Rattiputz/plateforme-robotique-mobile/Architecture/Architecture.jpg

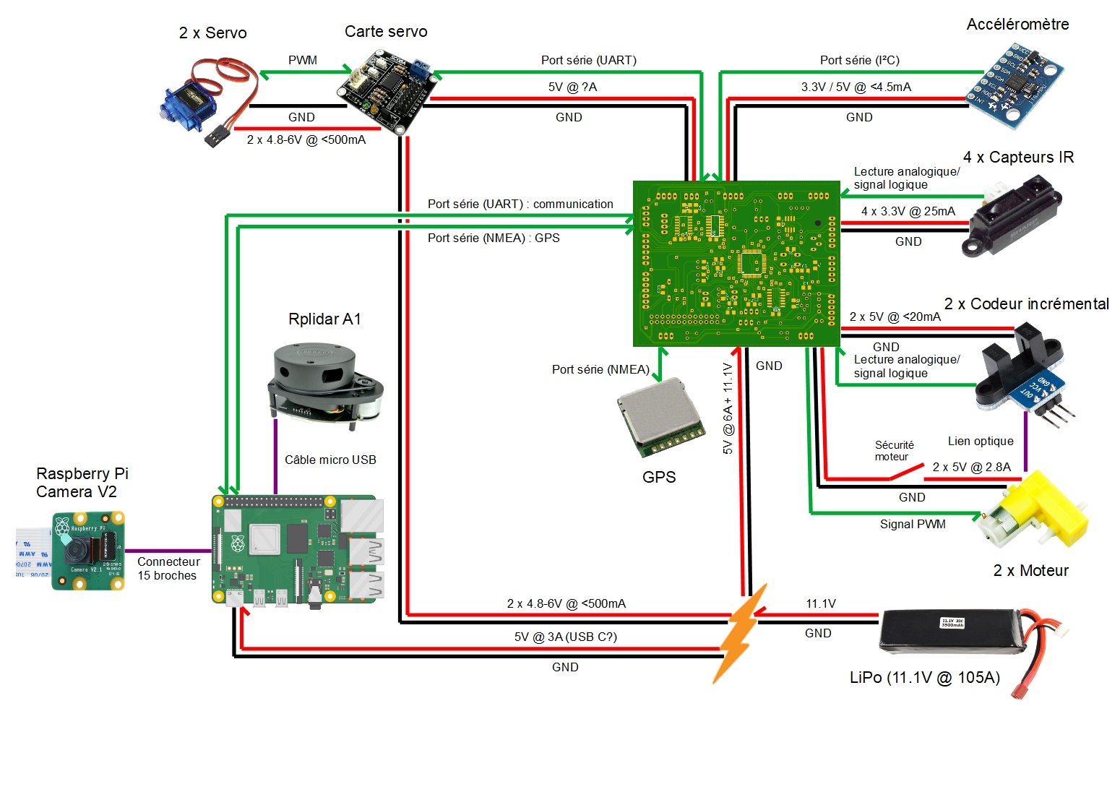
Architecture/Architecture.jpg
