Rattiputz/plateforme-robotique-mobile/prm_ws/src/prm_navigation/README.md

# prm_navigation

Le pkg prm_description contient :
- prm_teleop.launch qui permet le contrôle du robot par clavier
- amcl_demo.launch charge la carte de l'environnement et prépare le lancement de rviz (prm_descritption prm_rviz_amcl.launch) pour l'amcl
- gmapping_demo.launch prépare le lancement de rviz pour générer une carte (prm_decription prm_rviz_gmapping.launch)
