Rattiputz/plateforme-robotique-mobile/prm_ws/src/prm_description/README.md

# prm_description

Le pkg prm_description contient :
- prm_rviz.launch qui lance rviz pour visualiser les capteurs à partir du modèle sur ROS
- prm_rviz_amcl.launch qui lance rviz avec le Lidar activé
- prm_rviz_gmapping.launch qui lance rviz aussi... A COMPLETER :(
