Rattiputz/plateforme-robotique-mobile/Architecture/Architecture.odt

Architecture PRM

# Processeurs

- Raspberry Pi 4 B
- Microcontrôleur (PIC18F46K22-IPT)

# Capteurs

- RPLidar A1
- GPS
- Raspberry Pi Carte d’appareil photo V2
- 4 x Capteur distance infrarouge
- Accéléromètre 3 axes
- 2 x Codeur incrémental

# Alimentation

- Raspberry Pi 4 B (5V @ 3A) : Raspberry + Lidar + Camera
- Microcontrôleur (3.3V @ ??A)
- Moteurs (6V @ 2.8A) + Driver moteur
- 2 x Servo (4.8-6V @ 500mA) + Driver servos

Alimentation | V | A | Convertisseur | Fusible : 1 fusible en entrée (@11.1V)
Servomoteurs | 5V | 1.5A | OKI-78SR-5/1.5-W36-C | 0.68A
Moteurs | 5V | 6A | TOS06_12SIL | 2.7A
Raspberry Pi 4 + cartes 5V | 5V | 3.5A | TOS06_12SIL | 2.7A
µC + capteurs + GPS + autre | 3.3V | 500mA | R-78E3.3-0.5 | 0.23A

Fusible @ 11.1V : 6.3A

Liens :

# OKI-78SR-5/1.5-W36-C : https://fr.farnell.com/murata-power-solutions/oki-78sr-5-1-5-w36-c/convertisseur-dc-dc-7-5w-simple/dp/2102101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

TOS06_12SIL : https://fr.farnell.com/tracopower/tos-06-12sil/convertisseur-dc-dc-pol-6a-5v/dp/1007593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

# R-78E3.3-0.5 : https://fr.farnell.com/recom-power/r-78e3-3-0-5/conv-dc-dc-3-3v-500ma-out-thru/dp/2218602

LP2950-33LPE3 : https://fr.farnell.com/texas-instruments/lp2950-33lpe3/regulateur-micrpwr-3-3v-sd-to92/dp/2436388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

SPI : https://learn.sparkfun.com/tutorials/serial-peripheral-interface-spi/all

http://ww1.microchip.com/downloads/en/devicedoc/spi.pdf
