Rattiputz/plateforme-robotique-mobile/prm_ws/src/prm_control/README.md

# prm_control

Le pkg prm_control contient prm_control.launch qui initialise les controlleurs (tourelle caméra, roues...).
