Rattiputz/plateforme-robotique-mobile/prm_ws/src/prm_gazebo/README.md

# prm_gazebo

Le pkg prm_description contient prm_world.launch qui démarre la simulation sur gazebo et lace le robot.
