Rattiputz/plateforme-robotique-mobile/documentation/Electronique/Carte_uc_pcb.png

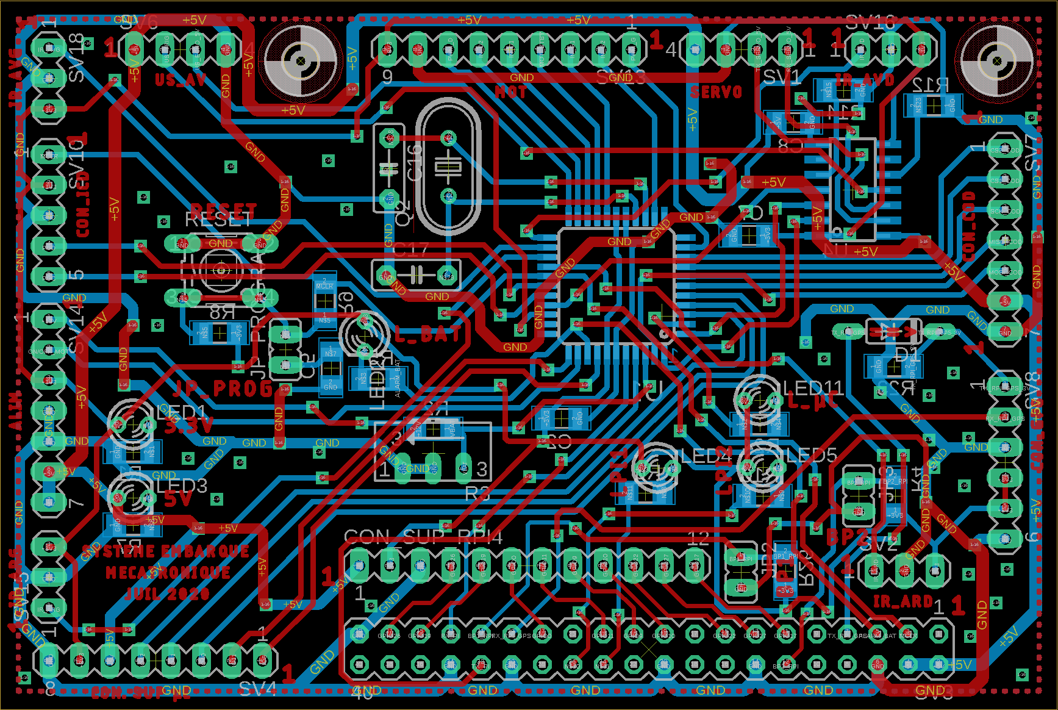
documentation/Electronique/Carte_uc_pcb.png
