Rattiputz/plateforme-robotique-mobile/documentation/Electronique/Carte_uc_schema.png

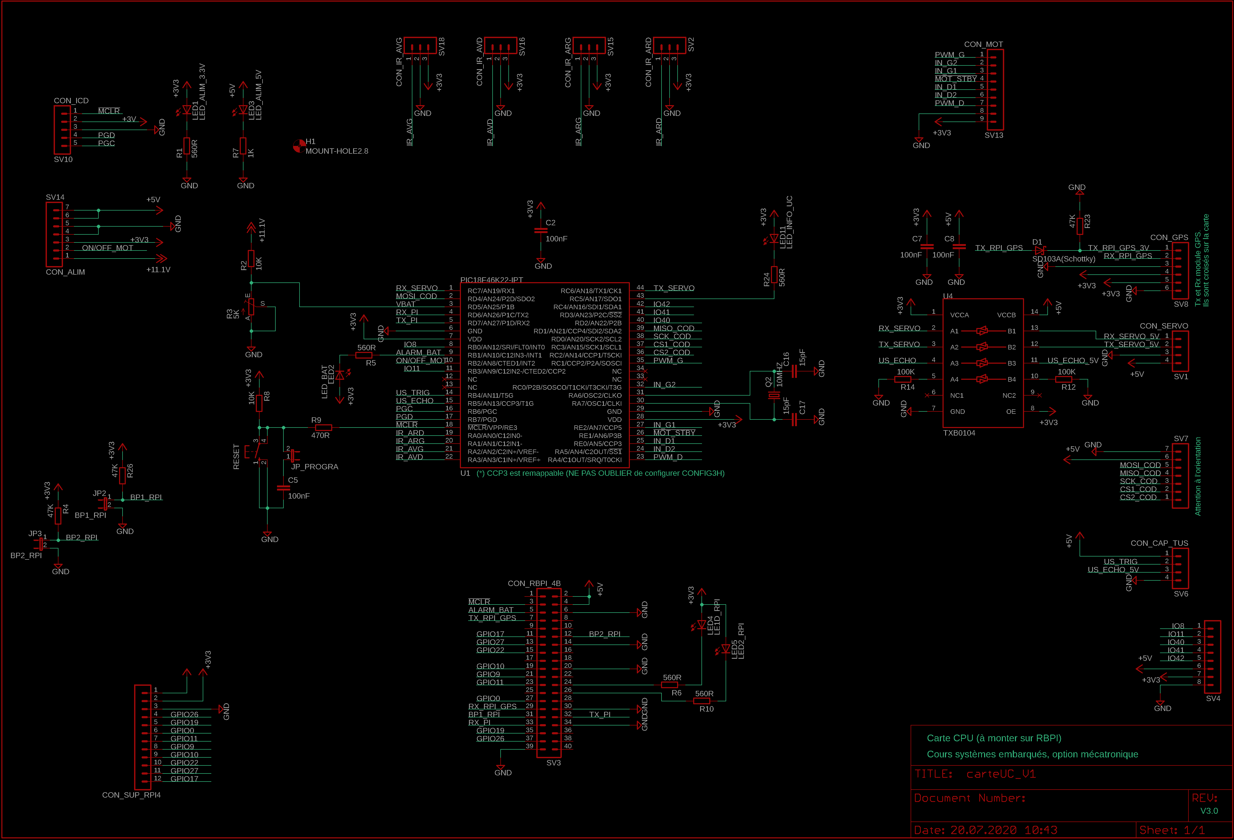
documentation/Electronique/Carte_uc_schema.png
