Rattiputz/plateforme-robotique-mobile/CAO/PRM_components_urdf_description/meshes/camera_1.stl

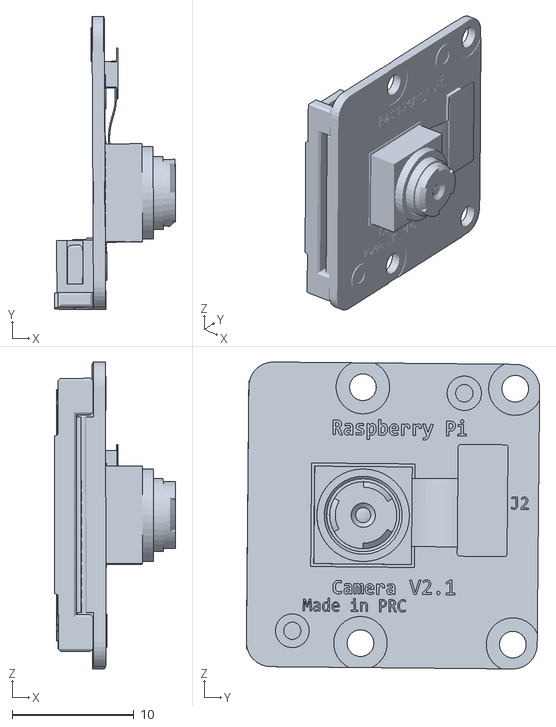
[picture p10: CAD file, 2020-05-07]
CAO/PRM_components_urdf_description/meshes/camera_1.stl
9.94 x 24.1 x 25.2
