Rattiputz/plateforme-robotique-mobile/prm_ws/src/prm_description/meshes/right_wheel_3.stl

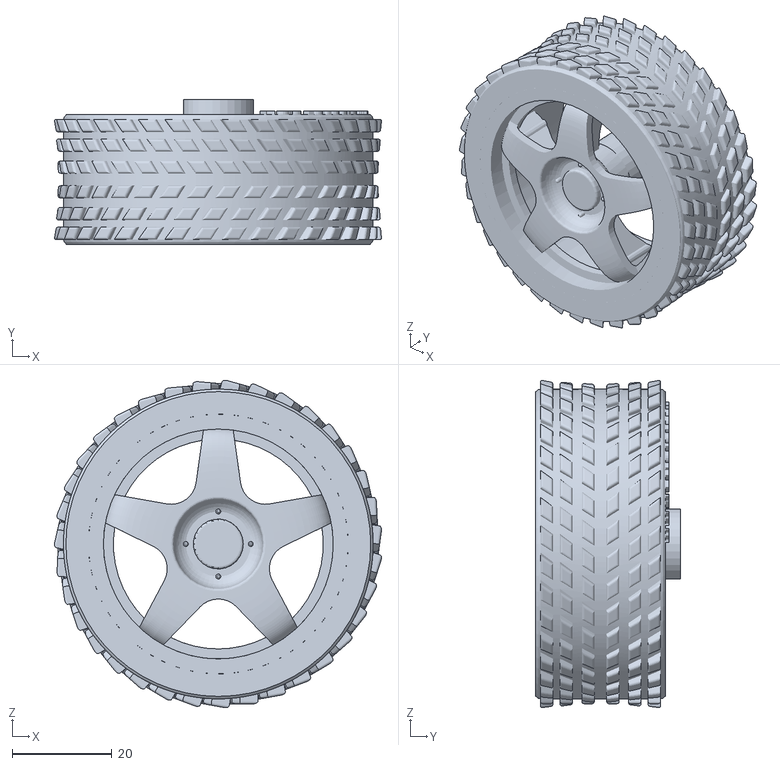
[picture p11: CAD file, 2020-05-07]
prm_ws/src/prm_description/meshes/right_wheel_3.stl
65.4 x 29.0 x 65.5
