Rattiputz/plateforme-robotique-mobile/CAO/PRM_components_urdf_description/meshes/lien_plaque_sup_1.stl

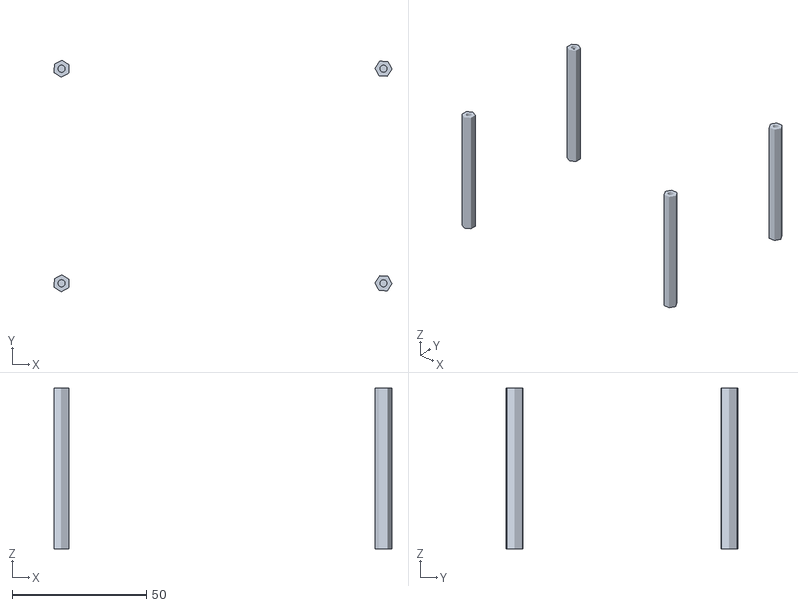
[picture p12: CAD file, 2020-05-07]
CAO/PRM_components_urdf_description/meshes/lien_plaque_sup_1.stl
126.0 x 86.3 x 60.0
