Rattiputz/plateforme-robotique-mobile/prm_ws/src/prm_description/meshes/base_link.stl

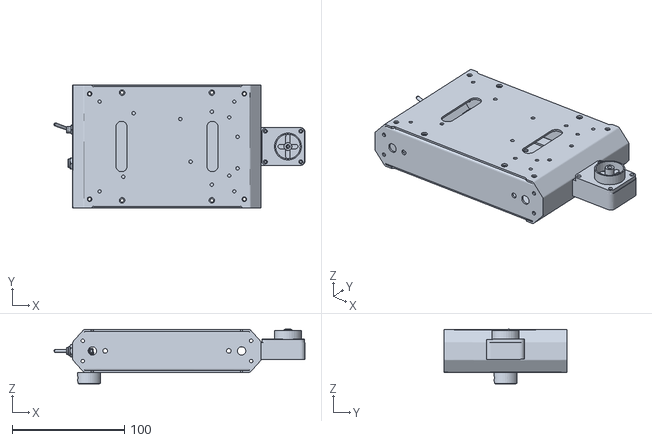
[picture p13: CAD file, 2020-05-07]
prm_ws/src/prm_description/meshes/base_link.stl
223.7 x 110.0 x 48.6
