Rattiputz/plateforme-robotique-mobile/CAO/PRM_components_urdf_description/meshes/plaque_sup_1.stl

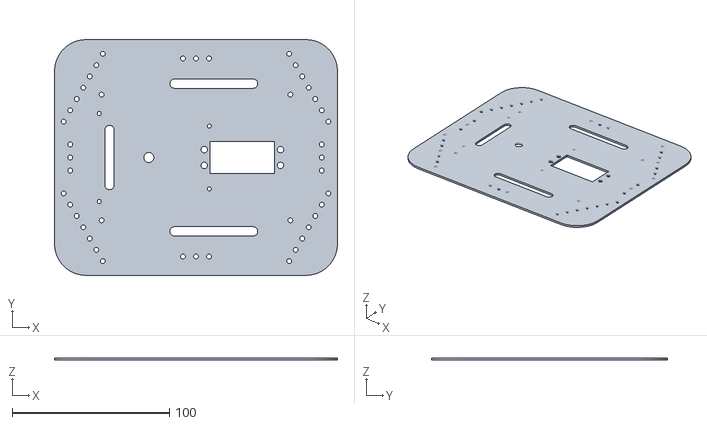
[picture p14: CAD file, 2020-05-07]
CAO/PRM_components_urdf_description/meshes/plaque_sup_1.stl
180.0 x 150.0 x 1.50
