Rattiputz/plateforme-robotique-mobile/prm_ws/src/prm_description/meshes/left_wheel_1.stl

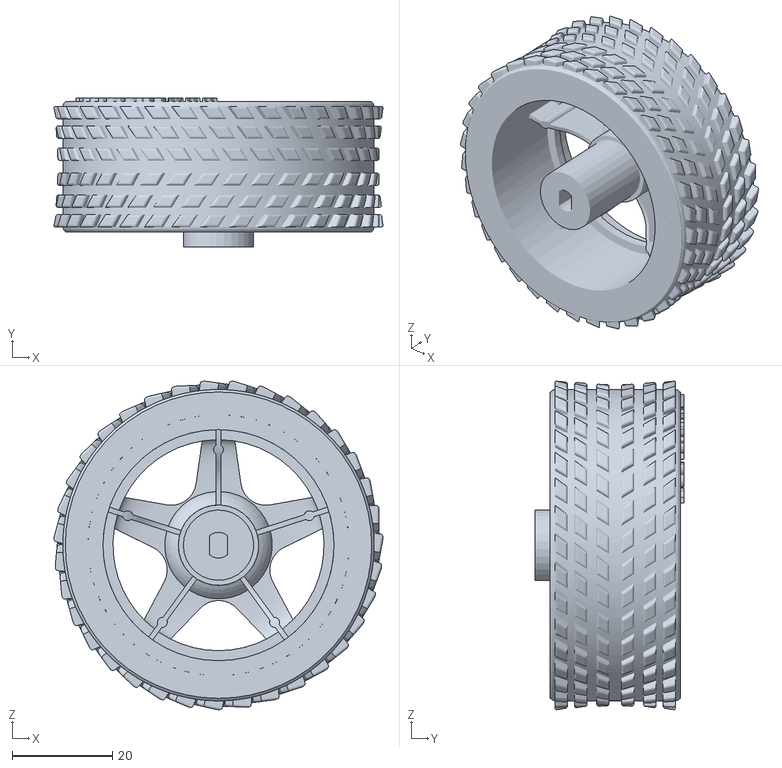
[picture p15: CAD file, 2020-05-07]
prm_ws/src/prm_description/meshes/left_wheel_1.stl
65.5 x 29.7 x 65.4
