Rattiputz/plateforme-robotique-mobile/CAO/PRM_components_urdf_description/meshes/pan_1.stl

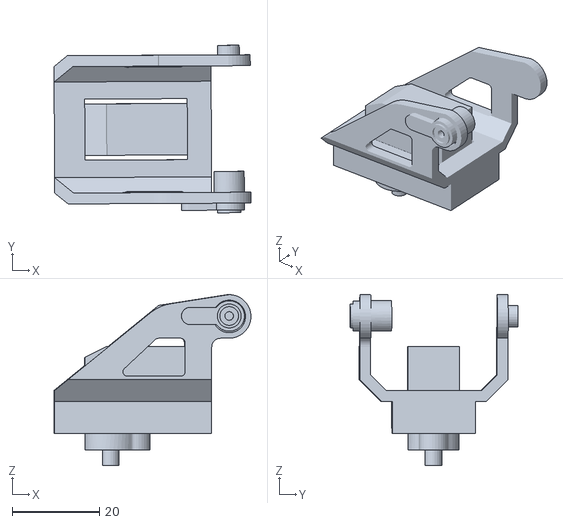
[picture p16: CAD file, 2020-05-07]
CAO/PRM_components_urdf_description/meshes/pan_1.stl
45.2 x 38.4 x 39.2
