Rattiputz/plateforme-robotique-mobile/CAO/PRM_components_urdf_description/meshes/bille_porteuse_1.stl

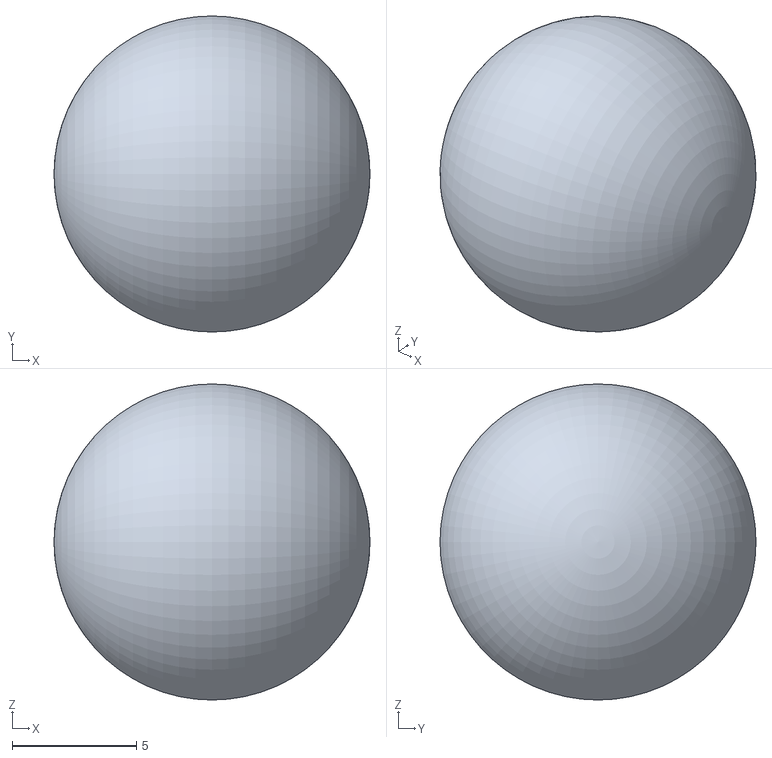
[picture p17: CAD file, 2020-05-07]
CAO/PRM_components_urdf_description/meshes/bille_porteuse_1.stl
12.7 x 12.7 x 12.7
