Rattiputz/plateforme-robotique-mobile/prm_ws/src/prm_description/meshes/laser_1.stl

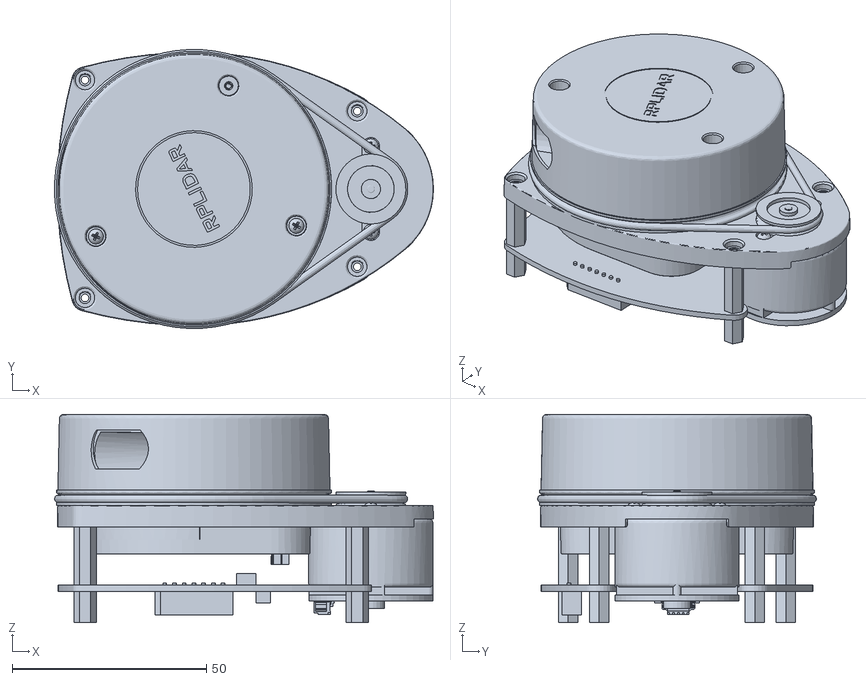
[picture p18: CAD file, 2020-05-07]
prm_ws/src/prm_description/meshes/laser_1.stl
97.4 x 71.7 x 53.5
