Rattiputz/plateforme-robotique-mobile/prm_ws/src/prm_description/meshes/tilt_1.stl

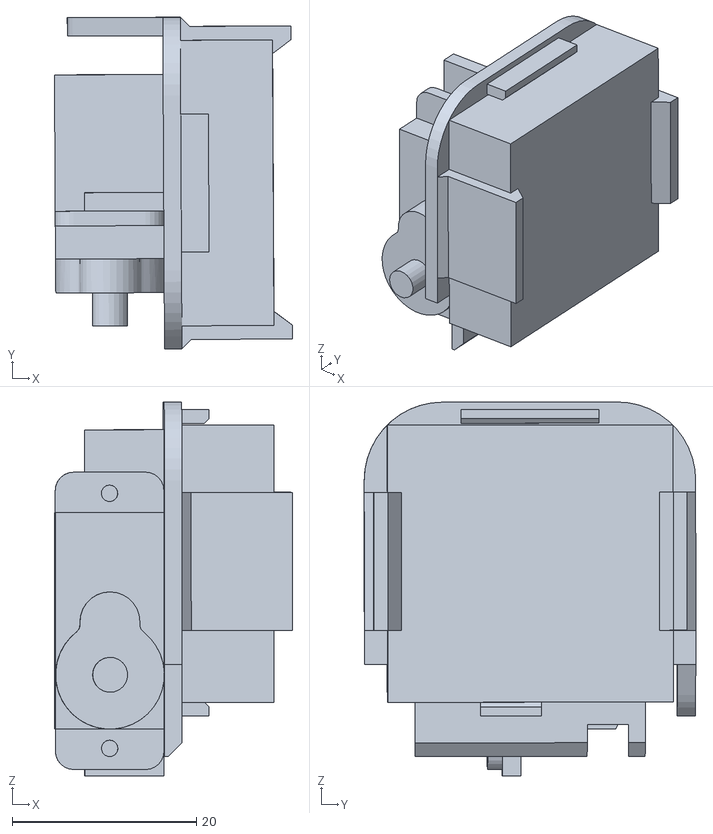
[picture p19: CAD file, 2020-05-07]
prm_ws/src/prm_description/meshes/tilt_1.stl
25.9 x 36.0 x 40.6
