Rattiputz/plateforme-robotique-mobile/documentation/procedes_installation.txt

Préliminaires --------------------------------------------

Drivers Nvidia:
Avant tout, tester si le pc s'éteint correctement. Si non, installer les drivers nvidia avec:

sudo apt-get install nvidia-384
ou
sudo apt-get install nvidia-430

Tutorial GitHub:
https://product.hubspot.com/blog/git-and-github-tutorial-for-beginners

Installation de ROS sur ordinateur --------------------------------------------

ROS:
http://wiki.ros.org/kinetic/Installation/Ubuntu (installer ros-kinetic-ros-base)

1. Ici on n'installe que ROS base (sudo apt-get install ros-kinetic-ros-base). Par la suite, nous installerons gazebo9 (alors que la version par défaut est gazebo7). Nous installerons les autres packages nécessaires manuellement.

2. Vérifier que ROS est bien installé avec:

roscore

(passer à la suite après l'actualisation de rosdep).

Gazebo9 (seulement sur ordinateur):
https://medium.com/@abhiksingla10/setting-up-ros-kinetic-and-gazebo-8-or-9-70f2231af21a
http://gazebosim.org/tutorials?tut=install_ubuntu&cat=install

1. Suivre les instructions manuelles du deuxième lien pour récupérer les repos des versions de gazebo adaptées à ROS kinetic (ne pas installer gazebo-11).
2. Reprendre le premier lien à l'installation de gazebo9. S'assurer que les packages sont bien présents auparavent.

En plus des packages cités, installer:

1. sudo apt-get install ros-kinetic-joint-state-publisher ros-kinetic-joint-state-publisher-gui ros-kinetic-robot-state-publisher (bon lancement de rviz)
2. sudo apt-get install ros-kinetic-gmapping (gmapping)
3. sudo apt-get install ros-kinetic-turtlebot (diriger le robot au clavier)
4. sudo apt-get install ros-kinetic-map-server ros-kinetic-amcl ros-kinetic-move-base (permettre la navigation autonome)
5. sudo apt-get install ros-kinetic-tf-conversions (hector slam)

Installation de Ubuntu Mate 16.04 sur Raspberry Pi 4 --------------------------------------------

Ubuntu 16.04 Mate sur Raspberry Pi 4:

https://ubuntu-mate.community/t/is-there-a-ubuntu-mate-for-raspberry-pi-4/19943/4

0. S'il y a des problèmes pour connecter la carte SD à l'ordinateur, la commande suivante devrait résoudre le problème (il faut malheureusement redémarrer le PC à chaque fois):

sudo apt-get install --reinstall udisks2
sudo reboot

1. Ce procédé est plus simple avec 2 cartes SD, mais une suffit (effectuer d'abord l'étape 2.). Sur une première carte SD, flasher Ubuntu 16.04 Mate (armhf) de manière native (Ubuntu) ou avec un outil dédié (Windows, type BalenaEtcher). Pour télécharger Ubuntu:

wget https://ubuntu-mate.org/raspberry-pi/ubuntu-mate-16.04.2-desktop-armhf-raspberry-pi.img.xz

2. Sur une deuxième carte SD, flasher Raspian Buster:

https://www.raspberrypi.org/downloads/raspbian/

3. Enregistrer /boot et /rootfs/lib/modules de l'image Raspian. Supprimer le boot de la carte avec Ubuntu et remplacer par le /boot enregistré. Remplacer /rootfs/lib/modules de Ubuntu par le dossier /modules enregistré.

4. Changer cmdline.txt (dans /boot) en:

dwc_otg.lpm_enable=0 console=serial0,115200 console=tty1 root=/dev/mmcblk0p2 rootfstype=ext4 elevator=deadline fsck.repair=yes rootwait

Normalement il faudrait changer le PARTUUID (ou le UUID) dans cette ligne de commande. Puisqu'il est apparement difficile de le trouver sur le système modifié (il ne démarre pas avant d'avoir renseigné le UUID), cette solution est plus simple: on renseigne au /boot que la prochaine partition sur la carte SD est /root. Le système devrait maintenant pouvoir démarrer sur la Raspberry Pi 4.

5. Pour s'assurer que la Raspberry Pi 4 démarre bien, nous allons mettre en place le SSH:

https://www.youtube.com/watch?v=8qleH35Kgjk
https://thepihut.com/blogs/raspberry-pi-tutorials/19668676-renaming-your-raspberry-pi-the-hostname

etape 1: insérer un fichier text brut vide nommé "ssh" sur PI_BOOT (attention à ne pas lui donner d'extension comme .txt. Il est possible de vérifier dans les propriétés que le fichier n'a pas d'extension).

etape 2: dans l'onglet réseau sur l'ordinateur, cliquer Modification des connections... -> Ajouter -> Ethernet, puis dans les paramètres IPv4 sélectionner "Partagé avec d'autres ordinateurs". Dans les paramètres IPv6, sélectionner "Ignorer".

etape 3: connecter la Raspberry Pi par ethernet et sélectionner la connection créée à l'étape 2 (il est judicieux de la nommer afin de la retrouver facilement). Utiliser:

hostname -I

pour trouver l'IP de l'ordinateur, puis avec l'ip trouvée faire:

sudo nmap -sP -PI -PT *IP*/24

etape 4: faire:

sudo nano /media/magnus/PI_ROOT/etc/hostname

et noter le nom de la Raspberry.

etape 5: faire:

sudo ssh -X prmraspi@*IP trouvée avec nmap* (ici, sudo ssh -X prmraspi@10.42.0.201)

et entrer le mot de passe par défaut (raspberry). Si la connection n'est pas établie, il faut manuellement activer le ssh sur la Raspberry avec la commande

sudo systemctl enable ssh

etape 6: faire:

gnome-terminal &

pour avoir plusieurs terminaux sur cette même connection SSH (https://askubuntu.com/questions/332104/open-another-terminal-window-with-the-same-ssh-session-as-original-window). ctrl+maj+t permet d'ouvrir un nouvel onglet.

6. Modifier le mot de passe de la Raspberry:

sudo raspi-config -> Change User Password

Étant donné la faible sécurité du réseau de l'école, il est mandatoire de changer le mot de passe pour éviter de donner l'accès root à un inconnu une fois connecté sur le réseau de l'école.

7. Augmenter la taille de root

En ssh, faire

gparted

et augmenter la taille de la deuxième partition

Installation de ROS sur Raspberry Pi --------------------------------------------

Même installation que sur pc en passant l'installation de gazebo9 (non nécessaire sur la Raspberry). Il faut cette fois installer

ros-kinetic-desktop-full

en s'assurant que les packages précisés ci-dessus sont bien installés.

Mise en oeuvre --------------------------------------------

Lien entre Raspberry et PC:
https://github.com/mktk1117/six_wheel_robot/wiki/Communication-between-Raspberry-Pi-and-PC-(ROS)

1. Faire ifconfig sur PC et Raspberry et récupérer les adresses IP. Ensuite, faire:

sudo nano /etc/hosts

et ajouter:

# Adresses IP ROS
10.42.0.1       pc-ros
10.42.0.201     raspberry-1

sur PC et Raspberry (en substituant les adresses IP correctes).

2. Sur le PC (qui sera maître):

echo 'export ROS_HOSTNAME=pc-ros' >> ~/.bashrc
echo 'export ROS_MASTER_URI=http://pc-ros:11311' >> ~/.bashrc

3. Sur la Raspberry (qui sera esclave):

echo 'export ROS_HOSTNAME=raspberry-1' >> ~/.bashrc
echo 'export ROS_MASTER_URI=http://pc-ros:11311' >> ~/.bashrc

4. Tester la connection en faisant:

ping pc-ros (respectivement ping raspberry-1)

Ensuite, sur l'ordinateur lancer:

roscore

puis:

rostopic pub /test std_msgs/Float32 5.0

et sur la Raspberry:

rostopic echo /test

Normallement la Raspberry devrait afficher la valeur 5.0. Les deux ordinateurs sont maintenant connectés. Comme cette modification est permanente, il suffit d'utiliser le ssh pour avoir accès à la Raspberry.

Remarque: pour utiliser ros sur un ordinateur sans connexion au robot, il faut commenter les lignes:

export ROS_HOSTNAME=pc-ros
export ROS_MASTER_URI=http://pc-ros:11311

de .bashrc .

Changer de nom d'un package:
https://answers.ros.org/question/28165/renaming-a-package/

1. Changer le nom du dossier, le nom du projet (CMakeList.txt) et le nom du package (package.xml).
2. Lancer:

catkin_make

dans le workspace.

3. Faire:

rospack profile

pour que Ros trouve les changements.

Lancer le lidar sur Raspberry: ne pas oublier:

sudo chmod 666 /dev/ttyUSB0

Wiki --------------------------------------------

Cloner wiki:
git clone https://github.com/Rattiputz/plateforme-robotique-mobile.wiki.git

Markdown collaps:
https://gist.github.com/pierrejoubert73/902cc94d79424356a8d20be2b382e1ab

Mise en page wiki github:
https://help.github.com/en/github/writing-on-github/basic-writing-and-formatting-syntax (syntaxe sur github)

SLAM et tf --------------------------------------------

tmp: roslaunch prm_navigation amcl_demo.launch map_file:=/home/magnus/prm_ws/src/prm_navigation/maps/test_map.yaml

Ajouter repère Python (hector SLAM):
http://wiki.ros.org/tf/Tutorials/Adding%20a%20frame%20%28Python%29

Firmware lidar (Rpi):
Ne pas s'embêter avec si ttyUSB0 n'est pas detecté, prendre un câble qui marche... (https://github.com/robopeak/rplidar_ros)

HectorSLAM:
https://www.youtube.com/watch?v=Qrtz0a7HaQ4
https://github.com/tu-darmstadt-ros-pkg/hector_slam
https://answers.ros.org/question/337131/laser-scan-not-being-used-for-costmap/

Comprendre tf:
https://www.youtube.com/watch?v=dBATvRhvGRI
https://linklab-uva.github.io/autonomousracing/assets/files/L11-compressed.pdf

Conversion de laser scan en pointcloud:
https://answers.ros.org/question/11232/how-to-turn-laser-scan-to-point-cloud-map/
http://wiki.ros.org/laser_geometry

ROS SLAM navigation stack:
http://wiki.ros.org/navigation/Tutorials/RobotSetup
http://wiki.ros.org/move_base

Comprendre RPlidar et Hector SLAM:
https://www.youtube.com/watch?v=Qrtz0a7HaQ4

ROS control:
http://gazebosim.org/tutorials/?tut=ros_control

Combiner plusieurs capteurs dans ROS navigation stack:
https://answers.ros.org/question/337131/laser-scan-not-being-used-for-costmap/

Pas de local costmap:
https://answers.ros.org/question/119051/local-costmap-empty-using-move_base_node/
https://wiki.ros.org/costmap_2d
http://www.programmersought.com/article/6482136097/

Problèmes généraux --------------------------------------------

Lancement de plusieurs robots:
https://www.theconstructsim.com/ros-qa-130-how-to-launch-multiple-robots-in-gazebo-simulator/

Problèmes de dépendance packages:
https://answers.ros.org/question/235061/could-not-find-tf_conversions-package-configuration-file/

Envoi de sensor_msgs/laserscan:
http://wiki.ros.org/navigation/Tutorials/RobotSetup/Sensors

Bonnes pratiques pour la gestion de packages:
https://answers.ros.org/question/12932/best-practice-urdf-descriptions-real-robots-gazebo-plugins-and-dependencies/

Contrôleurs (utilisation du joint_position_controller pour la tourelle caméra):
http://wiki.ros.org/ros_control
http://gazebosim.org/tutorials/?tut=ros_control
https://www.theconstructsim.com/ros-qa-070-moving-joints-gazebo-simple-example/

Haute utilisation du CPU Raspberry:
https://askubuntu.com/questions/798989/heavy-load-by-apt-unattended-upgrade

ROS communication avec Ubuntu+Raspberry:
https://github.com/mktk1117/six_wheel_robot/wiki/Communication-between-Raspberry-Pi-and-PC-(ROS)

UART:
https://www.raspberrypi.org/forums/viewtopic.php?t=244827
https://raspberrypi.stackexchange.com/questions/104464/where-are-the-uarts-on-the-raspberry-pi-4
https://raspberry-projects.com/pi/programming-in-c/uart-serial-port/using-the-uart
https://roboticsbackend.com/raspberry-pi-arduino-serial-communication/
(com UART)
https://www.youtube.com/watch?v=L6s489mcy8A   <---- Espagnol
(attribuer un nom fixe à une lisaison USB)
https://www.freva.com/2019/06/20/assign-fixed-usb-port-names-to-your-raspberry-pi/
(changer de nom)
https://www.domoticz.com/wiki/Assign_fixed_device_name_to_USB_port

Caméra: (sur Rasperry Pi)
https://discourse.ros.org/t/raspberry-pi-camera-node/1388
https://packages.ubiquityrobotics.com/
