Rattiputz/plateforme-robotique-mobile/documentation/ros-slam-navigation-stack-setup.jpg

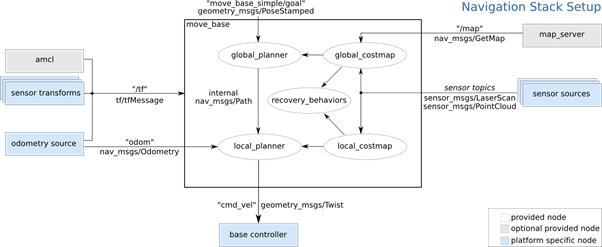
documentation/ros-slam-navigation-stack-setup.jpg
