Rattiputz/plateforme-robotique-mobile/CAO/PRM_components_urdf_description/launch/controller.yaml

PRM_components_urdf_controller:
  # Publish all joint states -----------------------------------
  joint_state_controller:
    type: joint_state_controller/JointStateController
    publish_rate: 50

  # Position Controllers --------------------------------------
  caster_position_controller:
    type: effort_controllers/JointPositionController
    joint: caster
    pid: {p: 100.0, i: 0.01, d: 10.0}
  rev_left_position_controller:
    type: effort_controllers/JointPositionController
    joint: rev_left
    pid: {p: 100.0, i: 0.01, d: 10.0}
  rev_right_position_controller:
    type: effort_controllers/JointPositionController
    joint: rev_right
    pid: {p: 100.0, i: 0.01, d: 10.0}
  tilt_joint_position_controller:
    type: effort_controllers/JointPositionController
    joint: tilt_joint
    pid: {p: 100.0, i: 0.01, d: 10.0}
  pan_joint_position_controller:
    type: effort_controllers/JointPositionController
    joint: pan_joint
    pid: {p: 100.0, i: 0.01, d: 10.0}
