Rattiputz/plateforme-robotique-mobile/(commit log)

2020-04-12 Nouvelle version de fusion2urdf
2020-04-15 Actualisation de la documentation
2020-04-20 Support pour rplidar A1
    [prm.xacro]
2020-04-22 Mise à jour des procédés
2020-04-23 Correction caméra et implémentation temporaire du lidar réel
    [prm.xacro]
2020-04-24 Rotation du modèle de 90°
    [PRM_components_urdf.xacro, base_link.stl, bille_porteuse_1.stl, camera_1.stl, controller.yaml, laser_1.stl, left_wheel_1.stl, lien_plaque_sup_1.stl]
2020-04-24 Séparation de la simulation et du robot réel
    [prm.xacro, prm_reel.xacro]
2020-04-24 Rotation du robot de 90°
    [PRM_components_urdf.xacro, base_link.stl, bille_porteuse_1.stl, camera_1.stl, controller.yaml, laser_1.stl, left_wheel_1.stl, lien_plaque_sup_1.stl]
2020-04-27 Actualisation de la doc
2020-05-07 Ajout de hector SLAM
    [prm.xacro]
2020-05-07 Ajout du rapport de mission R&D
2020-05-29 Finalisation après retour de la mission
2020-05-29 Ajustement des packages pour la fin de la mission
    [prm_reel.xacro]
